technoblogy/big-time/README.md

# Big Time
A giant digital clock featuring four large LED displays.
For more information see: http://www.technoblogy.com/show?2WTD.
