technoblogy/big-time/Eagle files/BigTimeMain.brd

## EAGLE design Eagle files/BigTimeMain.brd (2020-01-28)

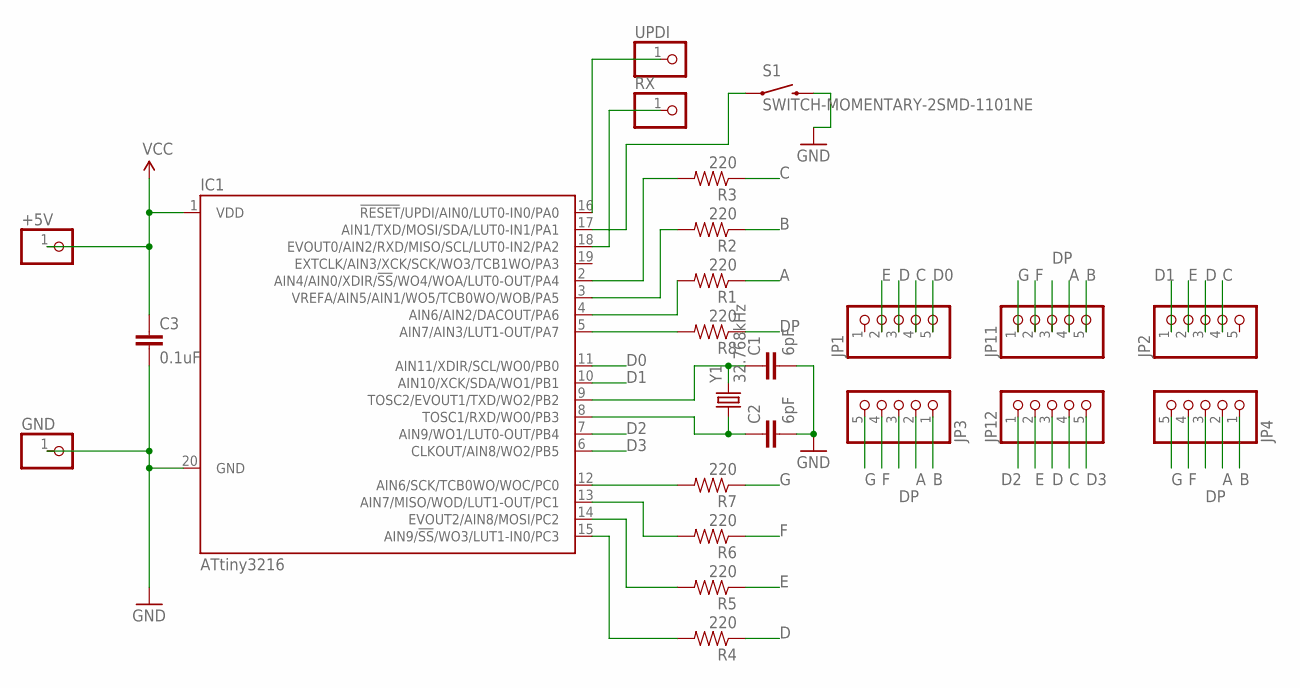
[picture p1: schematic BigTimeMain.sch]

Parts:
+5V: PINHD-1X1; 1X01
C1, C2: 6pF; 0805
C3: 0.1uF; 0805
GND: PINHD-1X1; 1X01
IC1: ATtiny3216; SOIC300
JP1, JP2, JP3, JP4, JP11, JP12: HEADER-1X576MIL; 1X05_ROUND_76
R1, R2, R3, R4, R5, R6, R7, R8: 220; 0805
RX: PINHD-1X1; 1X01
S1: SWITCH-MOMENTARY-2SMD-1101NE; TACTILE-SWITCH-1101NE
UPDI: PINHD-1X1; 1X01
Y1: 32.768kHz; CRYSTAL-SMD-3.2X1.5MM

Connections:
A: JP3.2, JP4.2, JP11.4, R1.1
B: JP3.1, JP4.1, JP11.5, R2.1
C: JP1.4, JP2.4, JP12.4, R3.1
D: JP1.3, JP2.3, JP12.3, R4.1
D0: IC1.11 (AIN11/XDIR/SCL/WO0/PB0), JP1.5
D1: IC1.10 (AIN10/XCK/SDA/WO1/PB1), JP2.1
D2: IC1.7 (AIN9/WO1/LUT0-OUT/PB4), JP12.1
D3: IC1.6 (CLKOUT/AIN8/WO2/PB5), JP12.5
DP: JP3.3, JP4.3, JP11.3, R8.1
E: JP1.2, JP2.2, JP12.2, R5.1
F: JP3.4, JP4.4, JP11.2, R6.1
G: JP3.5, JP4.5, JP11.1, R7.1
GND: C1.2, C2.2, C3.2, GND.1, IC1.20 (GND), S1.2
unnamed: C1.1, IC1.9 (TOSC2/EVOUT1/TXD/WO2/PB2), Y1.P$2 (2)
unnamed: C2.1, IC1.8 (TOSC1/RXD/WO0/PB3), Y1.P$1 (1)
unnamed: IC1.16 (!RESET!/UPDI/AIN0/LUT0-IN0/PA0), UPDI.1
unnamed: IC1.4 (AIN6/AIN2/DACOUT/PA6), R1.2
unnamed: IC1.3 (VREFA/AIN5/AIN1/WO5/TCB0WO/WOB/PA5), R2.2
unnamed: IC1.2 (AIN4/AIN0/XDIR/!SS!/WO4/WOA/LUT0-OUT/PA4), R3.2
unnamed: IC1.15 (AIN9/!SS!/WO3/LUT1-IN0/PC3), R4.2
unnamed: IC1.14 (EVOUT2/AIN8/MOSI/PC2), R5.2
unnamed: IC1.18 (EVOUT0/AIN2/RXD/MISO/SCL/LUT0-IN2/PA2), RX.1
unnamed: IC1.13 (AIN7/MISO/WOD/LUT1-OUT/PC1), R6.2
unnamed: IC1.12 (AIN6/SCK/TCB0WO/WOC/PC0), R7.2
unnamed: IC1.5 (AIN7/AIN3/LUT1-OUT/PA7), R8.2
unnamed: IC1.17 (AIN1/TXD/MOSI/SDA/LUT0-IN1/PA1), S1.1
VCC: +5V.1, C3.1, IC1.1 (VDD)

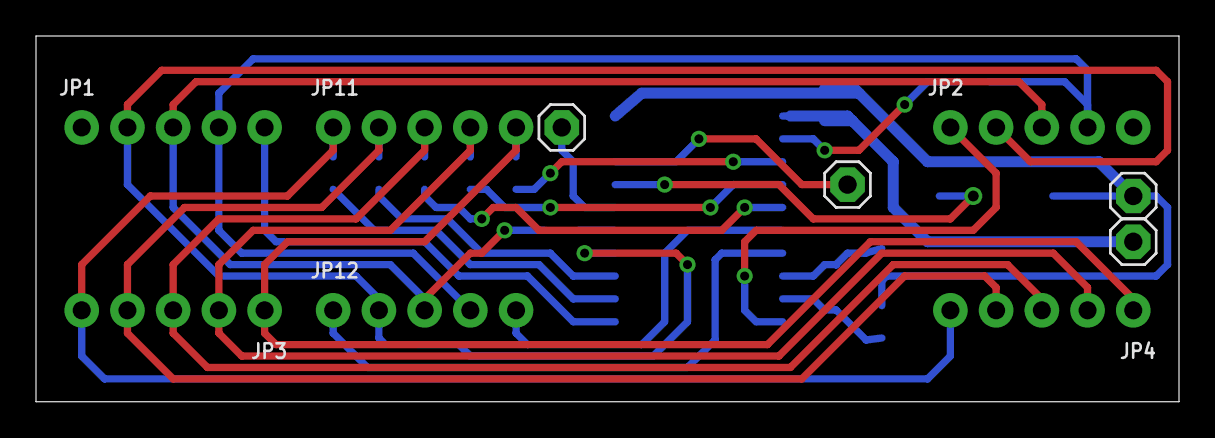
[picture p2: board BigTimeMain.brd from above]

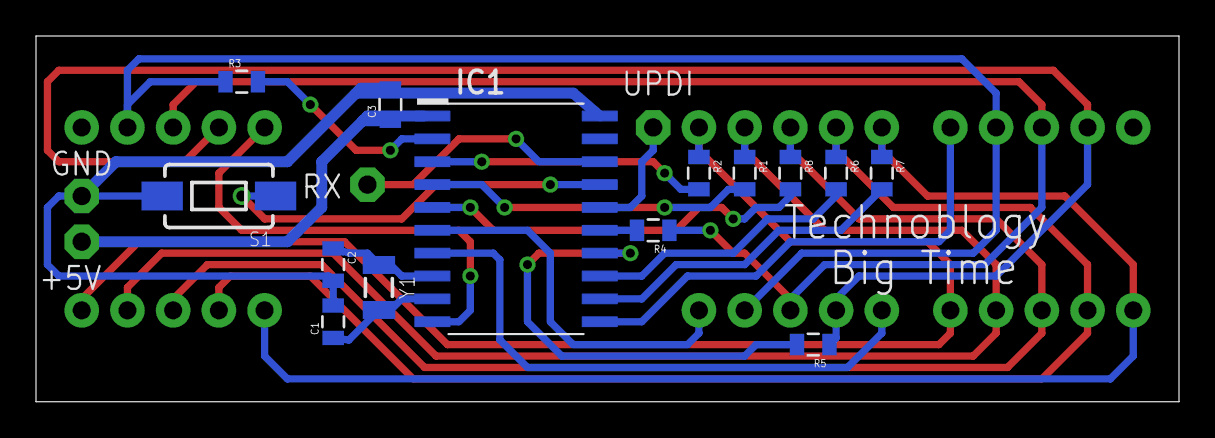
[picture p3: board BigTimeMain.brd from below]

Board: 2 copper layers, 63.5 x 20.3 mm, 24 parts (14 on the bottom side), 27 nets.
