technoblogy/big-time/Eagle files/BigTimeTop.brd

## EAGLE design Eagle files/BigTimeTop.brd (2020-01-28)

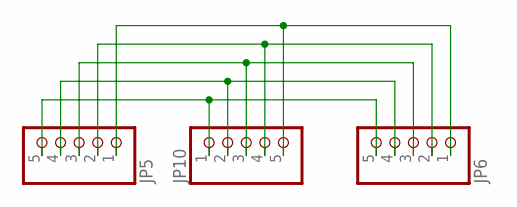
[picture p4: schematic BigTimeTop.sch]

Parts:
JP5, JP6, JP10: HEADER-1X576MIL; 1X05_ROUND_76

Connections:
unnamed: JP5.5, JP6.5, JP10.1
unnamed: JP5.4, JP6.4, JP10.2
unnamed: JP5.3, JP6.3, JP10.3
unnamed: JP5.2, JP6.2, JP10.4
unnamed: JP5.1, JP6.1, JP10.5

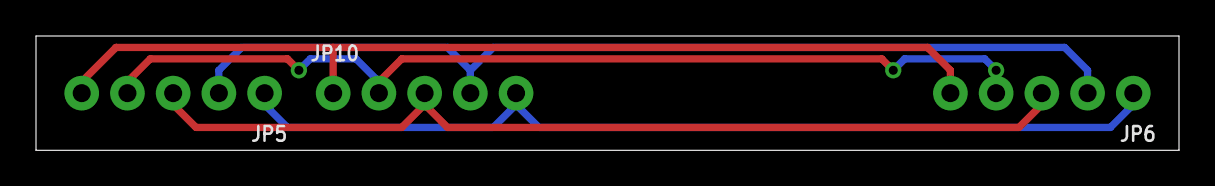
[picture p5: board BigTimeTop.brd from above]

Board: 2 copper layers, 63.5 x 6.4 mm, 3 parts (0 on the bottom side), 5 nets.
