technoblogy/big-time/Eagle files/BigTimeBottom.brd

## EAGLE design Eagle files/BigTimeBottom.brd (2020-01-28)

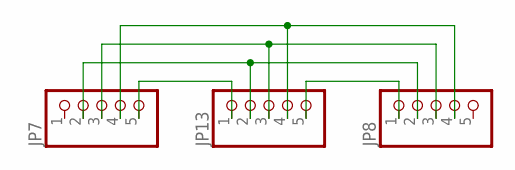
[picture p6: schematic BigTimeBottom.sch]

Parts:
JP7, JP8, JP13: HEADER-1X576MIL; 1X05_ROUND_76

Connections:
unnamed: JP7.5, JP13.1
unnamed: JP8.1, JP13.5
unnamed: JP7.2, JP8.2, JP13.2
unnamed: JP7.4, JP8.4, JP13.4
W1: JP7.3, JP8.3, JP13.3

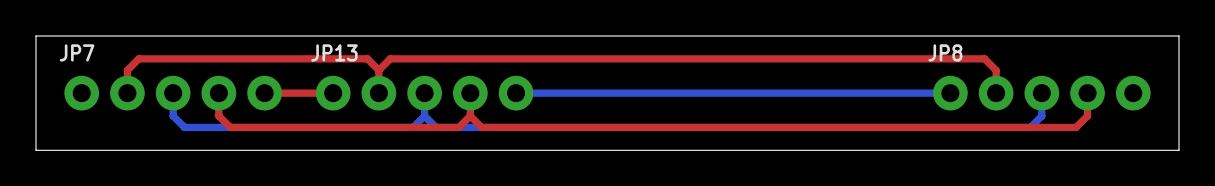
[picture p7: board BigTimeBottom.brd from above]

Board: 2 copper layers, 63.5 x 6.3 mm, 3 parts (0 on the bottom side), 5 nets.
