technoblogy/big-time/(commit log)

2020-01-28 Version 1 - 28th January 2020
    [BigTimeBottom.brd, BigTimeBottom.sch, BigTimeMain.brd, BigTimeMain.sch, BigTimeTop.brd, BigTimeTop.sch]
2025-01-28 Version 2 - 28th January 2025
    Minor fix.
    [BigTime.ino]
